PaulForgey/synth/wiremess.jpg

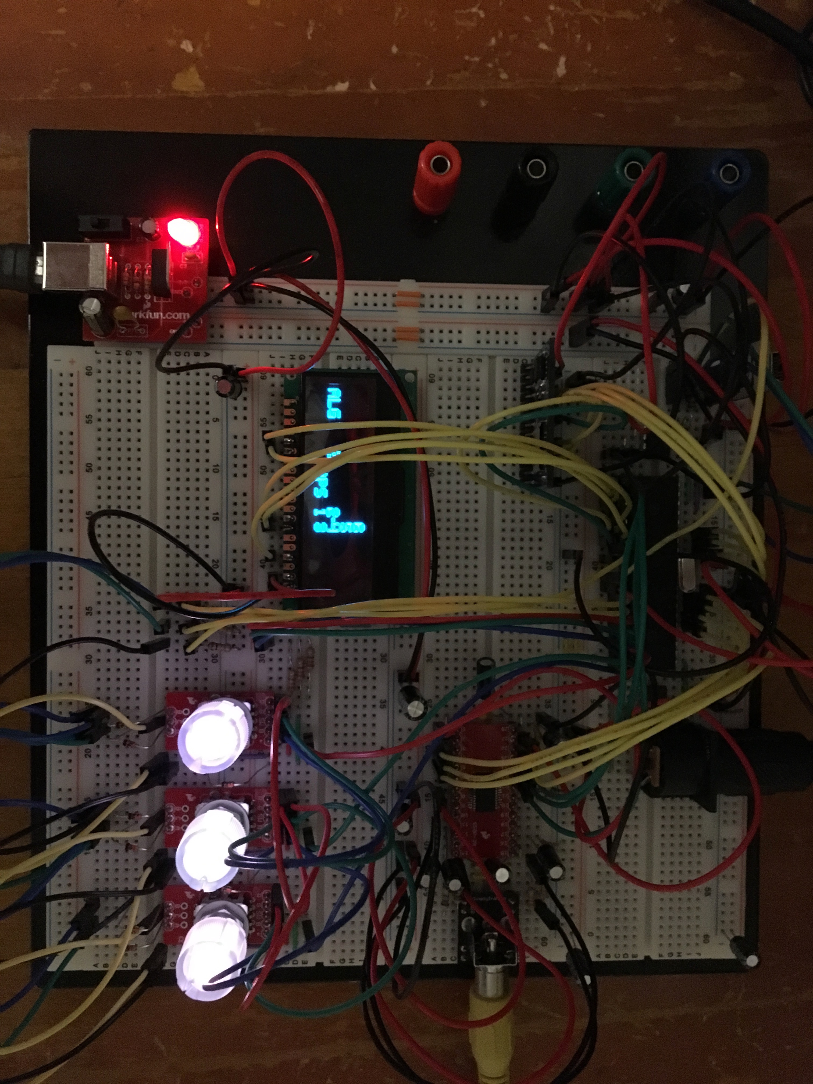
wiremess.jpg
