PaulForgey/synth/(threads)

Thread 1 (2017-01-30):

SPI bit banging needs to be assembly task in synth.io

PaulForgey, 2017-01-30:
Not only would the UI be tolerably faster, the repeated SPIN code per device consumes a lot of space

PaulForgey, 2017-01-31:
done. Code isn't actually smaller, but the UI is responsive enough to be worth it

Closed 2017-01-31.

Thread 2 (2017-01-30):

EG bias from modulation control isn't really workable

PaulForgey, 2017-01-30:
EG bias based on the modulation wheel needs to be reworked

Closed 2017-02-25.
