PaulForgey/synth/synth.oled.spin

{
The MIT License (MIT)

Copyright (c) 2017 PaulForgey

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
THE SOFTWARE IS PROVIDED "AS IS", WITHOUT WARRANTY OF ANY KIND, EXPRESS OR
IMPLIED, INCLUDING BUT NOT LIMITED TO THE WARRANTIES OF MERCHANTABILITY,
FITNESS FOR A PARTICULAR PURPOSE AND NONINFRINGEMENT. IN NO EVENT SHALL THE
AUTHORS OR COPYRIGHT HOLDERS BE LIABLE FOR ANY CLAIM, DAMAGES OR OTHER
LIABILITY, WHETHER IN AN ACTION OF CONTRACT, TORT OR OTHERWISE, ARISING FROM,
OUT OF OR IN CONNECTION WITH THE SOFTWARE OR THE USE OR OTHER DEALINGS IN THE
SOFTWARE.
}

OBJ
    io      : "synth.io"

VAR
    BYTE    Pin_

CON
    Sleep_Dim    = 0
    Sleep_Off    = 2
    Sleep_Normal = 3

PUB Init(Pin) | x
{{
Init OLED display
Pin     : Pin assigned to SPI CS line
}}
    Pin_ := Pin
    DIRA |= %100 ' address line

    Sleep(Sleep_Normal)
    repeat x from $b0 to $b3
        Send(0, x)
        Send(0, $00)
        Send(0, $10)
        repeat 132
            Send(1, 0)

PUB Sleep(s)
    Send(0, $ac | (s & $3))

PRI PutC(c) | ptr, inverse
{{
Paint a character at the display's current memory location
}}
        if c => 32  ' ASCII characters, which use 5 columns plus 1 blank
            if c & $80
                c &= $7f
                inverse := $ff
            else
                inverse := 0
            ptr := @BYTE[@Chars][(c-32) * 5]
            repeat 5
                Send(1, BYTE[ptr++] ^ inverse)
            Send(1, 0)
        else        ' Graphics characters, which also use all 6 columns
            ptr := @BYTE[@Graphics][(c-1) * 6]
            repeat 6
                Send(1, BYTE[ptr++])

PRI Point(row, col)
{{
Set the display's current memory location to the given row and column.
row     : 0-3, with 0 on top
col     : 0-42, 0 at left. Each column is 3 pixels, or 1/2 the width of a character cell
}}
    Send(0, $b0+row)
    Send(0, col & $f)
    Send(0, (col >> 4) | $10)

PUB Put(row, col, c)
{{
Put a character at a given row and column
row     : 0-3, with 0 on top
col     : 0-42, 0 at left. Each column is 3 pixels, or 1/2 the width of a character cell
}}
    Point(row, col*3)
    PutC(c)

PUB Write(row, col, str) | c, ptr, inverse
{{
Write a character string to a given row and column
row     : 0-3, with 0 on top
col     : 0-42, 0 at left. Each column is 3 pixels, or 1/2 the width of a character cell
}}
    Point(row, col*3)
    repeat while c := BYTE[str++]
        PutC(c)

PUB Clear(x1, y1, x2, y2) | y, x
{{
Clear top left x1,y1 to bottom right x2,y2
}}
    repeat y from y1 to y2
        Point(y, x1)
        repeat x from x1 to x2
            Send(1, 0)

PRI Send(a, d) | cs
{{
Send SPI byte to display device
a       : 0 for command, 1 for data
d       : 8 bit data
}}
    if a
        OUTA |= %100
    else
        OUTA &= CONSTANT(!%100)

    io.SendSpi(Pin_, 8, d)

DAT
' 6 bytes per tile
Graphics

' 1
' ....**
' ..**..
' .*....
' *.....
' ......
' ......
' ......
' ......
BYTE    %00001000
BYTE    %00000100
BYTE    %00000010
BYTE    %00000010
BYTE    %00000001
BYTE    %00000001

' 2
' **....
' ..**..
' ....*.
' .....*
' ......
' ......
' ......
' ......
BYTE    %00000001
BYTE    %00000001
BYTE    %00000010
BYTE    %00000010
BYTE    %00000100
BYTE    %00001000

' 3
' ......
' ......
' ......
' ......
' *.....
' .*....
' ..**..
' ....**
BYTE    %00010000
BYTE    %00100000
BYTE    %01000000
BYTE    %01000000
BYTE    %10000000
BYTE    %10000000

' 4
' ......
' ......
' ......
' ......
' .....*
' ....*.
' ..**..
' **....
BYTE    %10000000
BYTE    %10000000
BYTE    %01000000
BYTE    %01000000
BYTE    %00100000
BYTE    %00010000

' 5
' ......
' ....**
' ..**..
' **....
' ......
' ......
' ......
' ......
BYTE    %00001000
BYTE    %00001000
BYTE    %00000100
BYTE    %00000100
BYTE    %00000010
BYTE    %00000010

' 6
' **....
' ..**..
' ....**
' ......
' ......
' ......
' ......
' ......
BYTE    %00000001
BYTE    %00000001
BYTE    %00000010
BYTE    %00000010
BYTE    %00000100
BYTE    %00000100

' 7
' ......
' ......
' ......
' **....
' ..**..
' ....**
' ......
' ......
BYTE    %00001000
BYTE    %00001000
BYTE    %00010000
BYTE    %00010000
BYTE    %00100000
BYTE    %00100000

' 8
' ......
' ......
' ......
' ......
' ....**
' ..**..
' **....
' ......
BYTE    %01000000
BYTE    %01000000
BYTE    %00100000
BYTE    %00100000
BYTE    %00010000
BYTE    %00010000

' 9
' *.....
' *.....
' *.....
' *.....
' *...**
' *.**..
' **....
' *.....
BYTE    %11111111
BYTE    %01000000
BYTE    %00100000
BYTE    %00100000
BYTE    %00010000
BYTE    %00010000

' 10
' **....
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
BYTE	%0_1000001
BYTE	%0_1111111
BYTE	%0_0000000
BYTE	%0_0000000
' ^
' ..*..
' .*.*.
' .....
' .....
' .....
' .....
' .....
BYTE	%0_0000000
BYTE	%0_0000010
BYTE	%0_0000001
BYTE	%0_0000010
BYTE	%0_0000000
' _
' .....
' .....
' .....
' .....
' .....
' .....
' *****
BYTE	%0_1000000
BYTE	%0_1000000
BYTE	%0_1000000
BYTE	%0_1000000
BYTE	%0_1000000
