PaulForgey/synth/(commit log)

2017-01-31 SPI communication as synth.io task
    code didn't end up smaller for it, but the gain in UI response is
    worthwhile
    [synth.eg.spin, synth.oled.spin, synth.spin]
2017-02-02 take over voice in key down only as last resort
    fixes PaulForgey/synth/#4
    [synth.spin]
2017-02-07 do not mask channel with system common message
    ..because they don't have channel numbers! Solves a bug where the $f7
    byte would bounce around the midi loop until receiving another non $f7
    control byte.
    [synth.spin]
2017-02-08 use pitch envelope for pitch
    Now the multipliers (which, being in pitch units, are addition) simply
    add to the value of the pitch envelope. This means knowledge of which
    operators are fixed frequency moves into the EG so that it doesn't bend
    fixed frequencies.
    This paves the way for portamento in the upcoming mono mode. The pitch
    EG will be able to do all the work for that.
    [synth.eg.spin, synth.spin]
2017-02-10 mono mode!
    pitch R1 also acts as sort of a portamento. If a key is pressed with no
    other (single key down), the pitch EG immediately starts normally.
2017-02-12 tweak the UI a bit
    move the parameter up to the second line to align better with the
    context above it, also giving the menu line some space
    add vertical bars between the menu items, making it more obvious which
    is for which button
2017-02-13 track note on, off and sustain by channel number
2017-02-14 fix overmodulation problem
    ye olde offe by one problem. Also conceed we don't need 17 bit
    resolution on the operators, fixing an envelope shift overflow issue as
    well as making things easier to manage.
    This is a massive improvement controlling the timbre.
    [synth.eg.spin]
2017-02-15 auto scale outputs
    although the method of doing so is a bit crude. Anyway, it's safe to run
    carriers at $ff without clipping
    reduce attack noice by re-syncing oscillators once an envelope value
    reaches 0.
    forgot to adjust the shift value in the LFO output when reducing
    oscillator output from 17 bits to 16.
    [synth.eg.spin, synth.spin]
2017-02-18 better velocity sensititivity
    do away with the quick and cheesy floor value in favor of an actual way
    to do it. To counteract the exponential output of the levels, unscaled
    velocity values are given a log curve. Setting '0' meanas always at full
    output, setting '8' allows velocity 1 to be barely audible.
2017-02-26 take over notes better
    envelope state needs to be reset if the new note is taking over another
    playing voice (regardless of key up state, of course). Do this by
    panicing the envelopes in reverse order so things are silent before
    resetting the pitch enveleope. Also, the key down state of any other
    MIDI channel is naturally now up.
2017-02-28 bring operators down to 12 bit
    In what should be retrospectively obvious, matching the resolution of
    the output with the modulation granularity makes for a more controlled
    modulation and sounds better (and even if it didn't, the math makes a lot
    more sense this way).
    [synth.eg.spin]
2017-03-04 simplify envelope reset logic
    make envelope takeover/reset/not-resetting behavior make more sense, and
    avoid race condition where pitch EG could sometimes bend from nowhere.
    as we're giving up on auto scaling the output, save some room and let it
    just run unshifted with the DAC in 16 bit mode
    [synth.eg.spin, synth.spin]
2017-04-03 added preliminary schematic
    [synth.sch]
2017-04-11 drive both DAC channels
    with a 16 bit word size, it's easy enough to drive both channels, therefore do so.
    try to be less likely to drop MIDI messages. Although what this really
    needs is the decoding to be done in assembly, not Spin.
2017-04-28 Retrofit mono mode and key down/sustian tracking
    Do not keep track of key down or sustain by MIDI channel, as it really
    isn't worth the overhead to do it that way. Also, move the high note
    tracking into the voice and assign the voice by MIDI channel in mono
    mode, allowing for better operation of things like guitar controllers.
    As there are only 8 voices, MIDI channels $8-$f wrap their assignments
    of $0-$7
2017-04-30 set pitch _before_ rest of EGs
    eliminate a misguided optomization that could result in an intermittent
    clicking sound when key down
2017-06-10 Compare a patch while editing
    Cmd_Compare / CMP will do one of two things:
    If not in comparing state,
    Stash patch into temporary buffer and re-load from storage
    Set comparing state
    Else,
    Restore patch from temporary buffer
    Reset comparing state
    comparing state is cleared when loading a patch
    While it is possible to continue editing while comparing, this is not
    advisable. I may consider locking the UI to the Load selection in this
    state.
    [synth.spin]
2017-09-04 display sleep
    rather than keep display on all the time, dim after 5 seconds, then
    sleep 20 seconds after that. This should help extend the life of the
    OLED display.
    as the display updating is fast enough that we no longer need to delay
    drawing the graph portion of the display, remove the code for making
    that a time delay, gaining us room to implement the more important
    display sleep.
    [synth.oled.spin]
2017-10-09 48K sample rate
    optimize operators so that 48k sample rate output is possible
